cayox/chipcounter/README.md

# Chip Counter

Chipzähler mit Tagesverlauf, Vibrationsmotor und Touchscreen.

# BOM

Diese Materialien werden für das System benötigt:

| Device | Price  | Amount | Link |
|---|---|---|---|
| Raspberry PI 4B | 66€ | 1 | [Amazon](https://www.amazon.de/Raspberry-Pi-ARM-Cortex-A72-Bluetooth-Micro-HDMI/dp/B07TC2BK1X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,aps,85&sr=8-5) |
| 5" Touch Display | 39,99€ | 1 | [Amazon](https://www.amazon.de/ELECROW-Touchscreen-Monitor-Raspberry-Kompatibel/dp/B0CZ6L8DNJ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,aps,91&sr=8-10) |
| Button Set | 7,25€  | 1 | [Amazon](https://www.amazon.de/RUNCCI-YUN-Momentanen-Druckschalter%EF%BC%8CMini-DruckTaster-Wasserdicht/dp/B0825RCZJS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,aps,573&sr=8-1) |
| Schlüsselschalter | 9,03€  | 1 | [Amazon](https://www.amazon.de/Create-idea-Edelstahl-Vollmetall-Verriegelnder-Edelstahl-Metall-Schl%C3%BCsselschalter/dp/B0D35B4ZCB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,aps,75&sr=8-6&th=1) |
| Infrarot Sender und Empfänger  | 6,99€  | 1 | [Amazon](https://www.amazon.de/BOJACK-Infrarot-Emitter-IR-lampe-Empf%C3%A4ngerdiode-Infrarot-Emissions-Empf%C3%A4ngerr%C3%B6hre/dp/B08Y6Y9S5Q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,aps,212&sr=8-1) |
| GPIO Breakoput Board | 14,95€ | 1 | [Amazon](https://www.amazon.de/FREENOVE-Breakout-Raspberry-Terminal-Status/dp/B0BFB618CJ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,aps,172&sr=8-4) |
| Jumper Kabel | 5,94€  | 1 | [Amazon](https://www.amazon.de/Female-Female-Male-Female-Male-Male-Steckbr%C3%BCcken-Drahtbr%C3%BCcken-bunt/dp/B01EV70C78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,aps,278&sr=8-6) |
| Elektrische Bauteile | 18,69€ | 1 | [Amazon](https://www.amazon.de/Elektronisches-Bauelemente-Set-Transistor-Elektrolytkondensatoren-Widerst%C3%A4nde-Bauelemente-Sortiment/dp/B09GVZ4STX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,aps,152&sr=8-9) |
| 12V Vibrationsmotor (?) | 17,99€ | 1 | [Amazon](https://www.amazon.de/ICQUANZX-Gleichstrom-Vibrationsmotor-drehmomentstarke-Vibrationsmotoren-eisenrotierenden/dp/B0824V4M4R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,aps,125&sr=8-20) |
| PWM Drehzahl Steller | 7,99€  | 1 | [Amazon](https://www.amazon.de/WayinTop-Drehzahlsteller-Geschwindigkeitsregler-Niederspannungs-Steuerungsmodul/dp/B07ZPRM23X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) |
| 12V Netzteil | 8,90€  | 1 | [Amazon](https://www.amazon.de/Spannungswandler-Netzteil-f%C3%BCr-LED-Streifen-220/dp/B01G0Q3RWU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) |
| Doppelrelais 5V steuerspannung | 11,78€ | 1 | [Amazon](https://www.amazon.de/dp/B07QYLN6LD?psc=1) |

# Aufbau
Das System muss [wie folgt](schemactics/chip_counter.png) aufgebaut werden. Die genaue Pinbelegung kann aus der [Config](assets/config.toml)
entnommen werden.

## Stromlaufplan
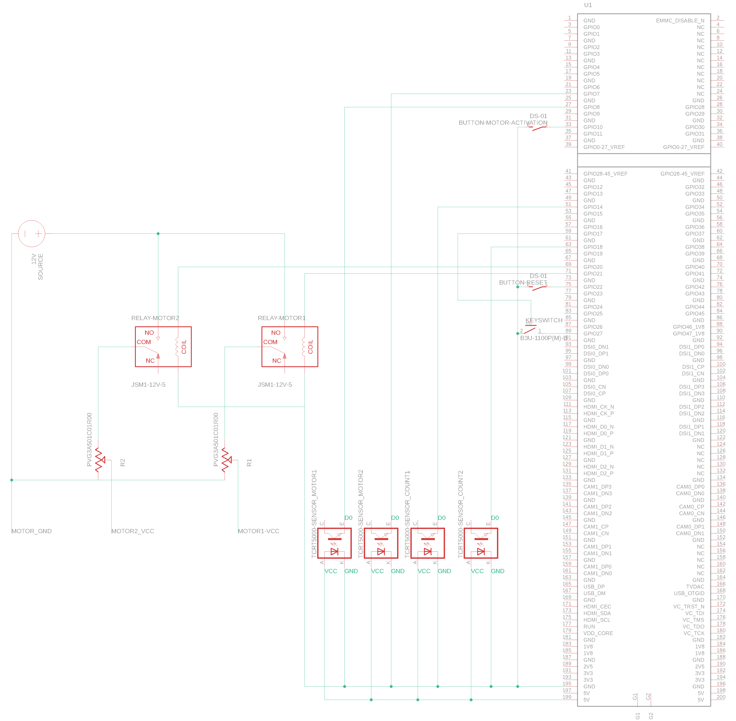
[picture p1: schematics/chip_counter.png]


# Bedienungsanleitung

Das System ist designt um Chips zu zählen. Da es zwei verschiedene Arten von
Chips gibt, werden zwei verschiedene Auffangbehältnisse eingerichtet, welche das 
System mit zwei Motoren unabhängig voneinander ansteuert, damit diese Vibrieren und
die Chips in den Zählschlitz befördern. Dort befindet sich ein Infrarotsensor, welcher 
die Chips je nach Farbe zählt und auf dem Display anzeigt. Am Einwurf der Auffangbehälter 
wird auch ein Infrarotsensor montiert, damit die Vibration automatisch eingeleitet wird.

## Bedienung
Das System inkorporiert mehrere Steuereinheiten um das Verhalten zu modifizieren.

* Motor manuell starten (`Pin 10`)
* Zähler auf der Hauptseite zurücksetzen (`Pin 22`)
* Hauptansicht anzeigen (`Pin 27`)
* Adminansicht anzeigen (`Pin 17`)

Zusätzlich können in der Adminansicht über den Touchscreen Einstellungen vorgenommen werden.

## Adminansicht

In der Adminansicht lassen sich die Daten des ganzen Tages wiederfinden, inklusive der Zählungen 
mit Faktor inkludiert. Die Daten werden stündlich in einem Barchart angezeigt, um Informationen
über die tägliche Auslastung zu erhalten. 

## Einstellungen

Durch die Adminansicht kann man auch in die Einstellungen (`Settings` oben rechts) gelangen.
In den Einstellungen kann die Motorlaufzeit und der Faktor eingestellt werden.
Zusätzlich kann man dort auch alle Zähler zurücksetzen und das Programm schließen.
