cayox/chipcounter/requirements/00_workflow_homeview.jpeg

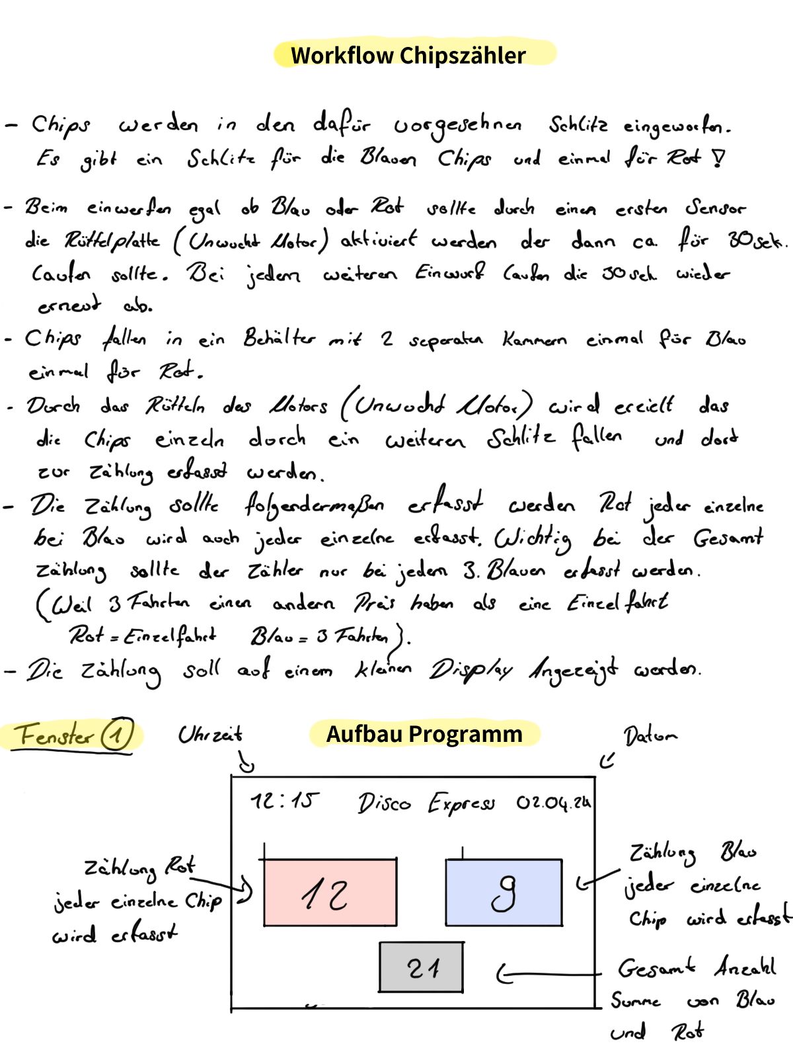
requirements/00_workflow_homeview.jpeg
