cayox/chipcounter/requirements/01_fenster2.jpeg

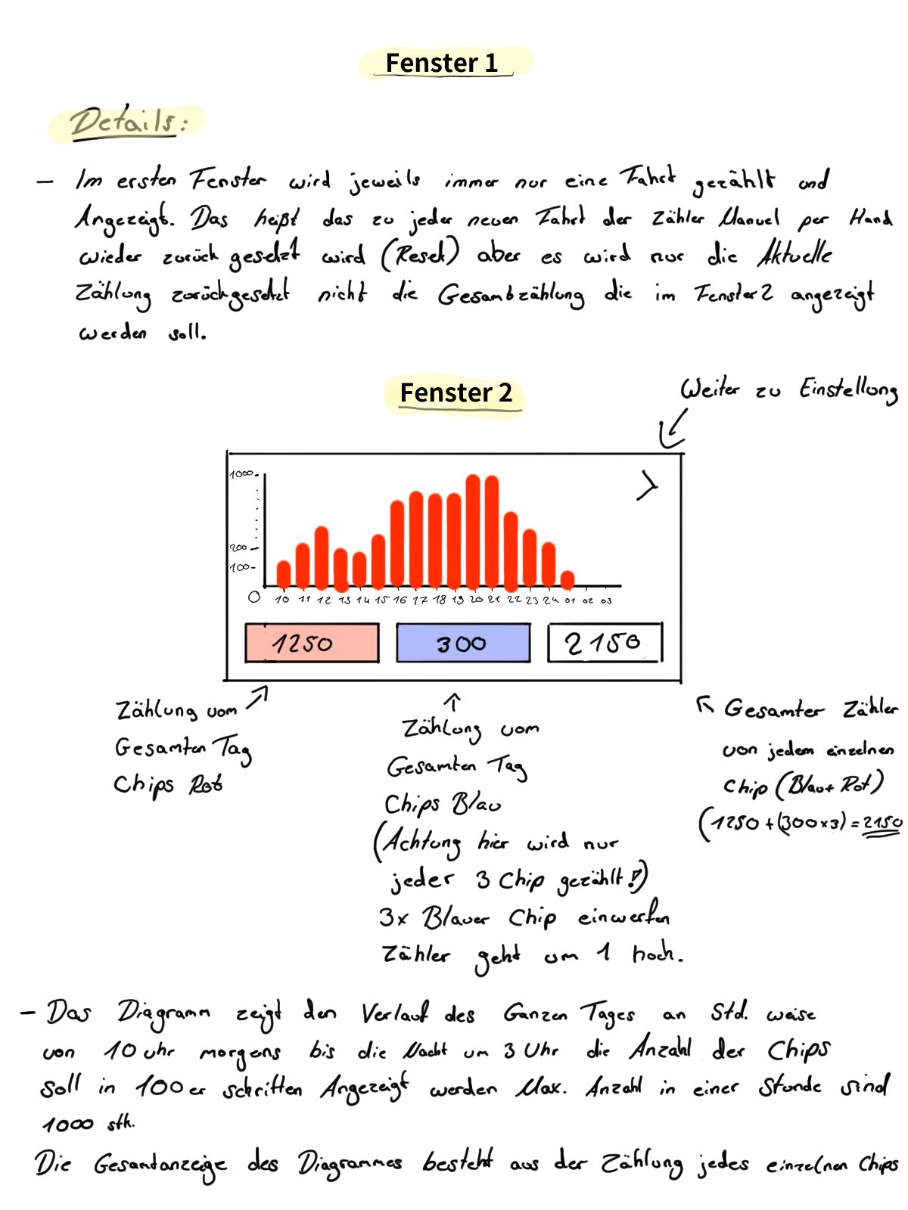
requirements/01_fenster2.jpeg
