cayox/chipcounter/requirements/02_fenster3.jpeg

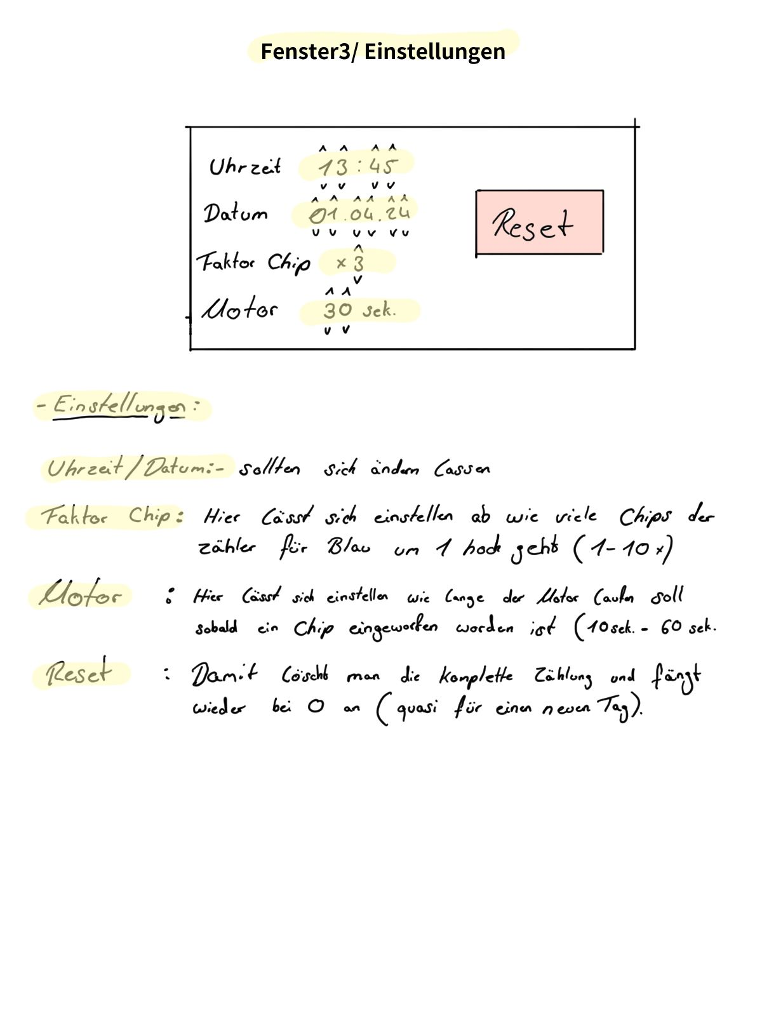
requirements/02_fenster3.jpeg
