cayox/chipcounter/schematics/chip_counter.sch

## EAGLE design schematics/chip_counter.sch (2024-08-05)

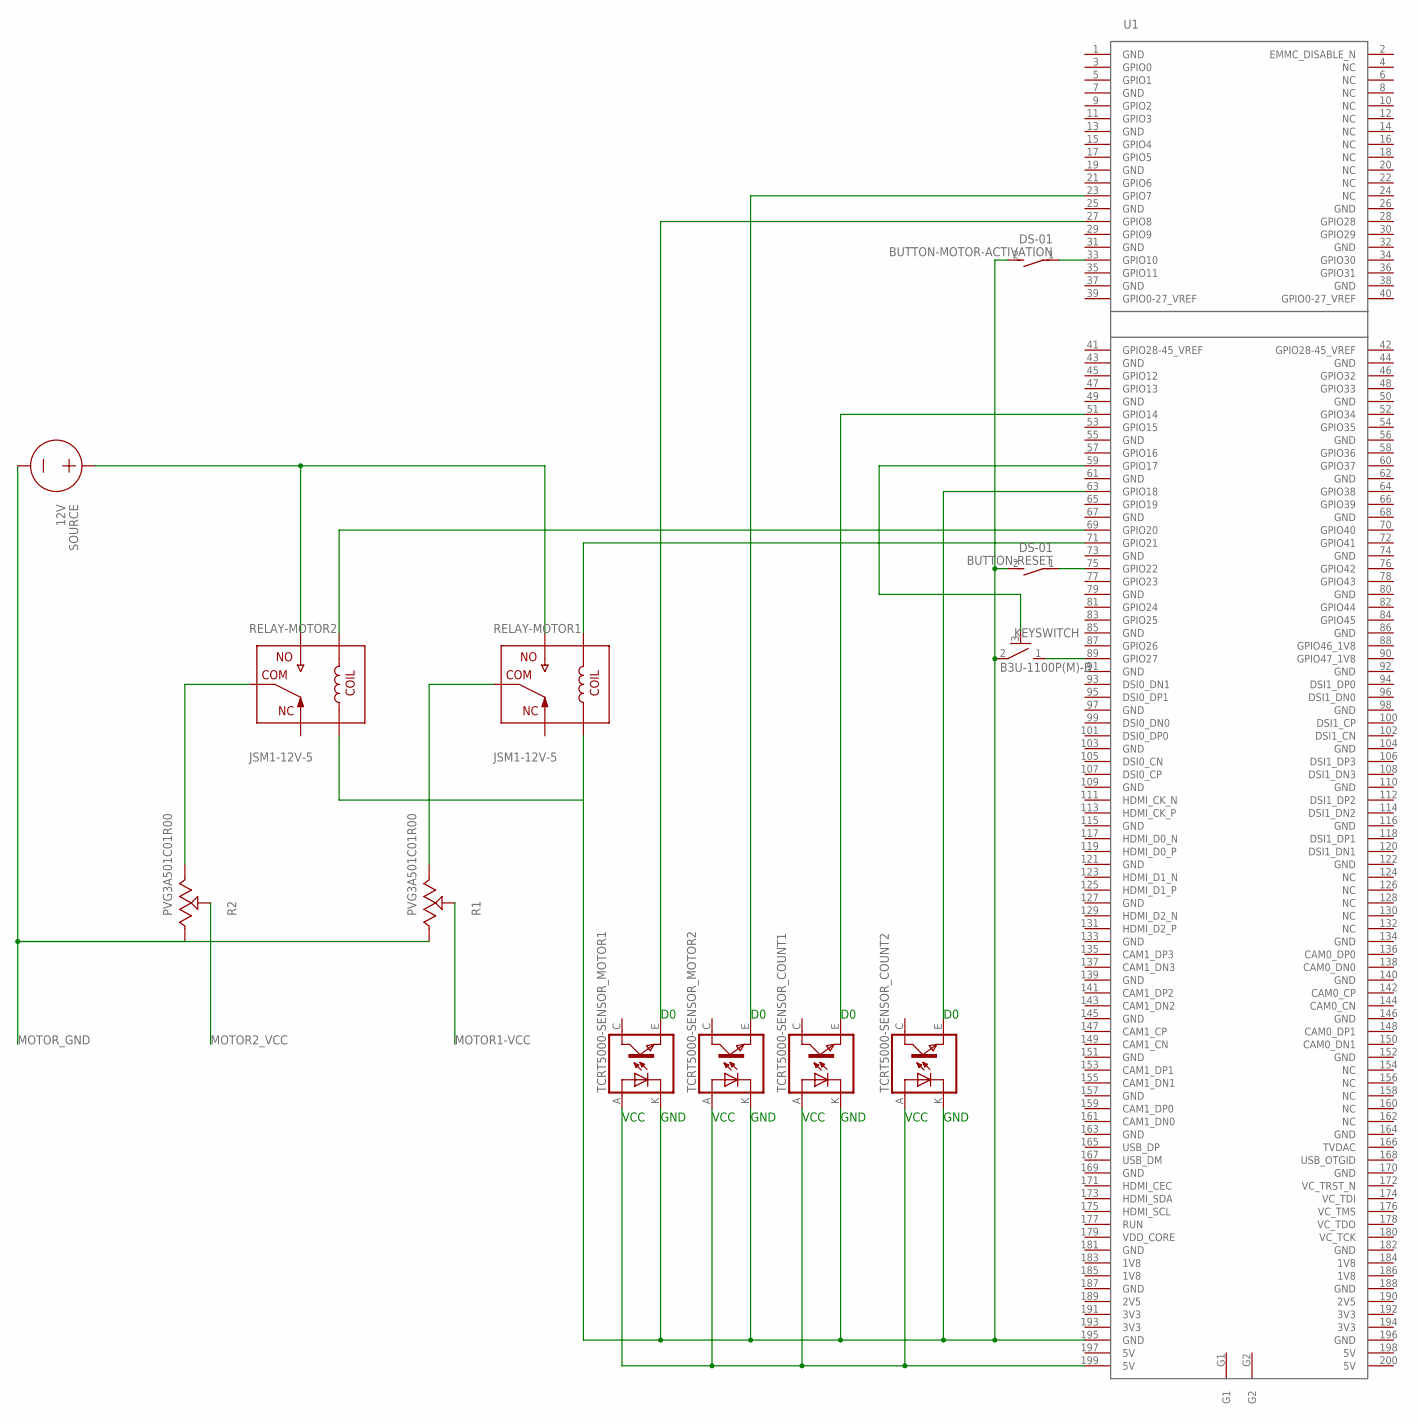
[picture p5: schematic chip_counter.sch]

Parts:
BUTTON-MOTOR-ACTIVATION: DS-01
BUTTON-RESET: DS-01
KEYSWITCH: B3U-1100P(M)-B
R1, R2: PVG3A501C01R00
RELAY-MOTOR1, RELAY-MOTOR2: JSM1-12V-5
TCRT5000-SENSOR_COUNT1, TCRT5000-SENSOR_COUNT2, TCRT5000-SENSOR_MOTOR1, TCRT5000-SENSOR_MOTOR2: TCRT5000
U1: COMPUTE_MODULE; SO-DIMM

Connections:
MOTOR1-VCC: R1.2
MOTOR2_VCC: R2.2
MOTOR_GND: R1.3, R2.3
unnamed: TCRT5000-SENSOR_COUNT1.A (ANODE), TCRT5000-SENSOR_COUNT2.A (ANODE), TCRT5000-SENSOR_MOTOR1.A (ANODE), TCRT5000-SENSOR_MOTOR2.A (ANODE), U1.199 (5V)
unnamed: TCRT5000-SENSOR_COUNT1.E (EMITTER), U1.51 (GPIO14)
unnamed: TCRT5000-SENSOR_COUNT2.E (EMITTER), U1.63 (GPIO18)
unnamed: TCRT5000-SENSOR_MOTOR1.E (EMITTER), U1.27 (GPIO8)
unnamed: TCRT5000-SENSOR_MOTOR2.E (EMITTER), U1.23 (GPIO7)
unnamed: BUTTON-MOTOR-ACTIVATION.2, BUTTON-RESET.2, KEYSWITCH.2 (1), RELAY-MOTOR1.5, RELAY-MOTOR2.5, TCRT5000-SENSOR_COUNT1.K (CATHODE), TCRT5000-SENSOR_COUNT2.K (CATHODE), TCRT5000-SENSOR_MOTOR1.K (CATHODE), TCRT5000-SENSOR_MOTOR2.K (CATHODE), U1.195 (GND)
unnamed: BUTTON-RESET.1, U1.75 (GPIO22)
unnamed: BUTTON-MOTOR-ACTIVATION.1, U1.33 (GPIO10)
unnamed: KEYSWITCH.3, U1.59 (GPIO17)
unnamed: KEYSWITCH.1 (2), U1.89 (GPIO27)
unnamed: RELAY-MOTOR1.2, U1.71 (GPIO21)
unnamed: RELAY-MOTOR2.2, U1.69 (GPIO20)
unnamed: RELAY-MOTOR1.3, RELAY-MOTOR2.3
unnamed: R2.1, RELAY-MOTOR2.1
unnamed: R1.1, RELAY-MOTOR1.1

Notes on the sheet:
VCC
GND
