cayox/chipcounter/requirements/03_gehäuse_aufbau.jpeg

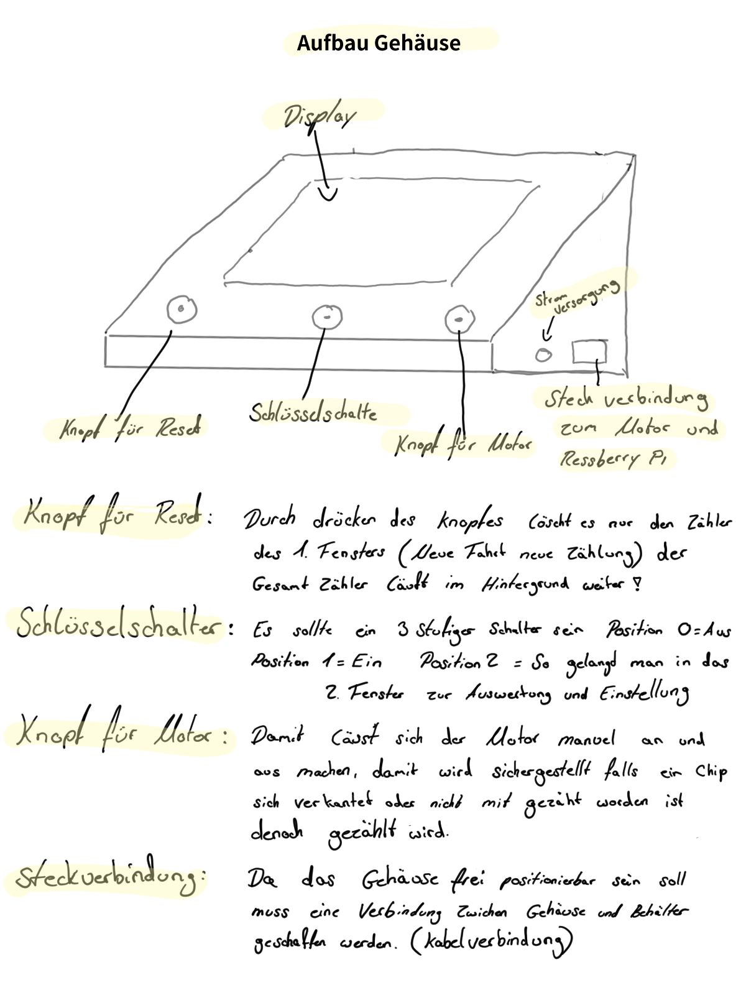
requirements/03_gehäuse_aufbau.jpeg
