cayox/chipcounter/(commit log)

2024-06-05 add BOM
2024-07-10 add ctrl LEDs
2024-07-10 add close button
2024-07-10 make sensor high active in code
2024-07-10 add logging to sensor thread
2024-07-10 make sensor low active in code
2024-07-10 use GPIO events for chip sensor edge detection
2024-07-10 make sensor lambdas accept all arguments
2024-08-04 finalize project
    [chip_counter.sch]
2024-08-05 update schematics
    [chip_counter.sch]
2024-08-13 fix ruff findings; cleanup repo
    [count_manager.py, gpio.py, main_controller.py]
2024-08-13 add sending schematics to pi
